fuhe5822720/-/购买元件和材料/购买元件和材料.docx

1. 外壳可以在建模sw中打开看，可以用3D打印
2. 电子元器件中的RGB灯可以用拼多多同款，便宜放心用
3. 电子元器件中的电容可以用淘宝同款，找靠谱店，便宜放心用
4. 嘉立创其他材料中的磁吸公母座可以用拼多多同款，大厂的便宜放心用
5. 嘉立创其他材料中USB磁吸充电电缆，改良了，这个太贵了，直接去掉
6. Esp8266min可以用淘宝up主同款，价格和拼多多差不多，但是拼多多人机客服，淘宝可以指点一下
7. 连接Esp8266min的线可以直接用杜邦线，便宜，目前用没问题
