fuhe5822720/-/购买元件和材料/电子元件清单-立创商城.xls

 |  | 立 创 商 城 订 单 详 情 WWW.SZLCSC.COM
商品明细列表
序号 | 商品编号 | 品牌 | 厂家型号 | 封装 | 商品名称 | 订购数量（修改后） | 是否不发此货 | 毛重（kg） | 商品单价 | 商品金额
1 | C722956 | BRIGHT(博瑞泰) | TSX103G901-250 | SMD | 10*10*9 弯型六脚 凹型柄 梅花H5.0 贴片 250gf | 5个 |  | 0.001430 | ￥3.220000/个 | ￥16.10
2 | C114586 | worldsemi | WS2812B-B | 5050(mm) | RGB三色 （注意防潮，请查阅规格书中对应具体内容） | 210个 |  | 0.000157 | ￥0.412595/个 | ￥86.64
3 | C136621 | SAMSUNG(三星) | CL21B104KBFNNNE | 0805 | 100nF ±10% 50V | 100个 |  | 0.000034 | ￥0.053756/个 | ￥5.38
