fuhe5822720/-/购买元件和材料/嘉立创外的其他材料.xlsx

材料 | 规格 | 数量 | 参考链接 | 备注
磁吸公母座 | 直针 | 10个 | https://item.taobao.com/item.htm?spm=a1z09.2.0.0.67002e8djU4Rxp&id=645077419824&_u=sd0tp5f8317 | 根据自己想做多少个模块觉得
USB磁吸充电电缆 | 白色直针 | 1 | https://item.taobao.com/item.htm?spm=a1z09.2.0.0.67002e8djU4Rxp&id=621136863981&_u=sd0tp5f55d2
螺丝 | M2*8【200颗】 | 1 | https://detail.tmall.com/item.htm?_u=sd0tp5f48bf&id=599899192777&spm=a1z09.2.0.0.67002e8djU4Rxp
亚克力 | 定制 | 看需求 | https://item.taobao.com/item.htm?spm=a1z09.2.0.0.67002e8djU4Rxp&id=40672059104&_u=sd0tp5f3cb8
防尘罩 | 根据模块数量决定 | 1 | https://item.taobao.com/item.htm?spm=a1z09.2.0.0.67002e8djU4Rxp&id=676704962844&_u=sd0tp5fbdb1
其他材料工具 | 热熔胶，电烙铁等常用电子制作工具
