fuhe5822720/-/模型文件/通用模块.SLDASM

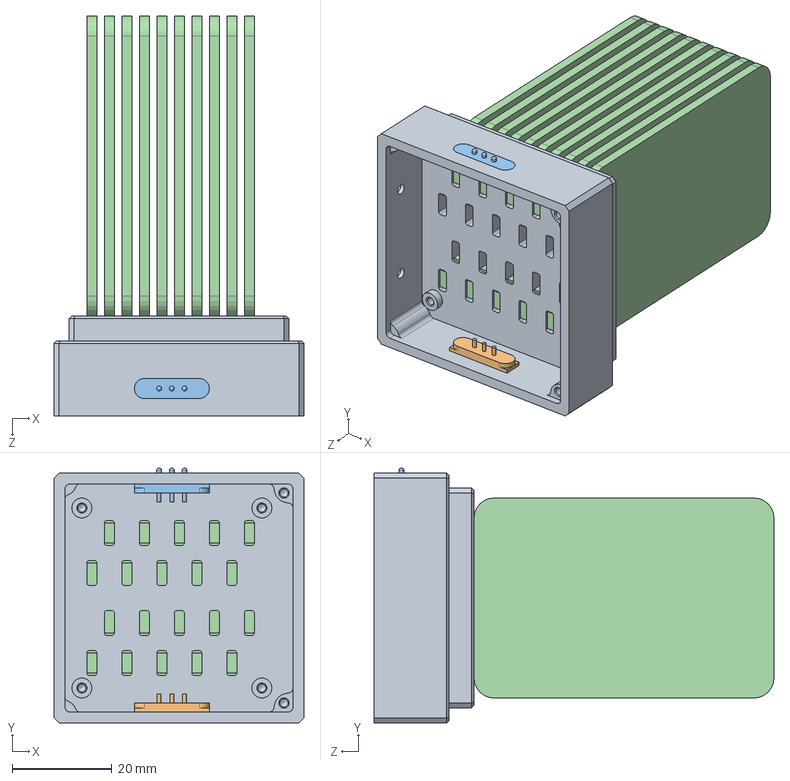
[picture p10: CAD file, 2026-10-09]
模型文件/通用模块.SLDASM
50.0 x 51.0 x 80.0 mm
底座_通用
3pin_母
3pin_公
亚克力显示片 x 10
