fuhe5822720/-/模型文件/总装配.SLDASM

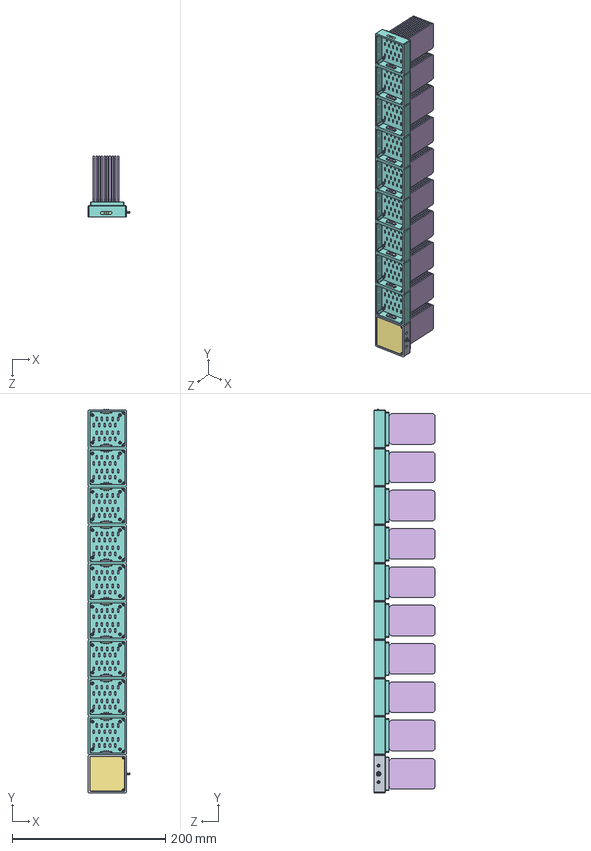
[picture p11: CAD file, 2026-10-09]
模型文件/总装配.SLDASM
54.5 x 501.0 x 80.0 mm
底座_信号0位
3D_led板_整体版
3D_5向开关_2022-10-30
3pin_公 x 10
电源2pin_母
亚克力显示片 x 100
底部盖子
底座_通用 x 9
3pin_母 x 9
