fuhe5822720/-/模型文件/信号模块_0位.SLDASM

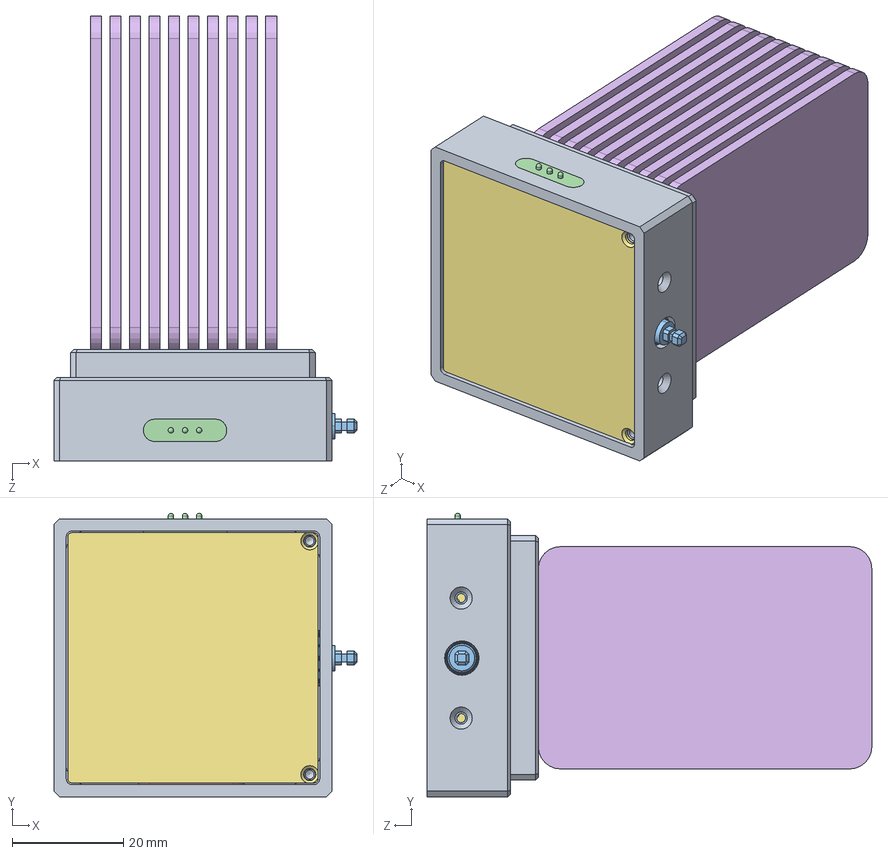
[picture p12: CAD file, 2026-10-09]
模型文件/信号模块_0位.SLDASM
54.5 x 51.0 x 80.0 mm
底座_信号0位
3D_led板_整体版
3D_5向开关_2022-10-30
3pin_公
电源2pin_母
亚克力显示片 x 10
底部盖子
