fuhe5822720/-/模型文件/亚克力显示片.SLDPRT

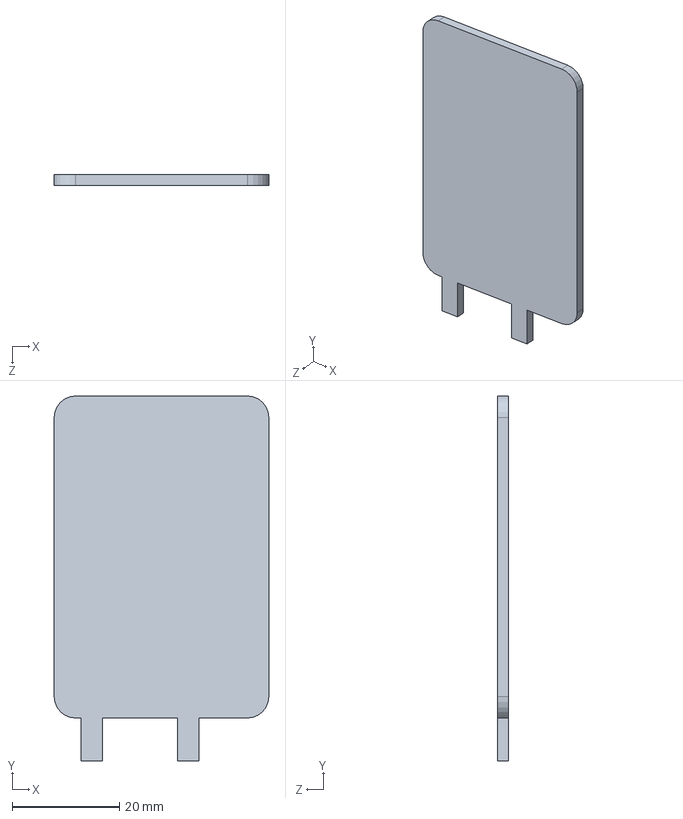
[picture p13: CAD file, 2026-10-09]
模型文件/亚克力显示片.SLDPRT
40.0 x 68.0 x 2.00 mm
