fuhe5822720/-/模型文件/led板_详细特征版.SLDPRT

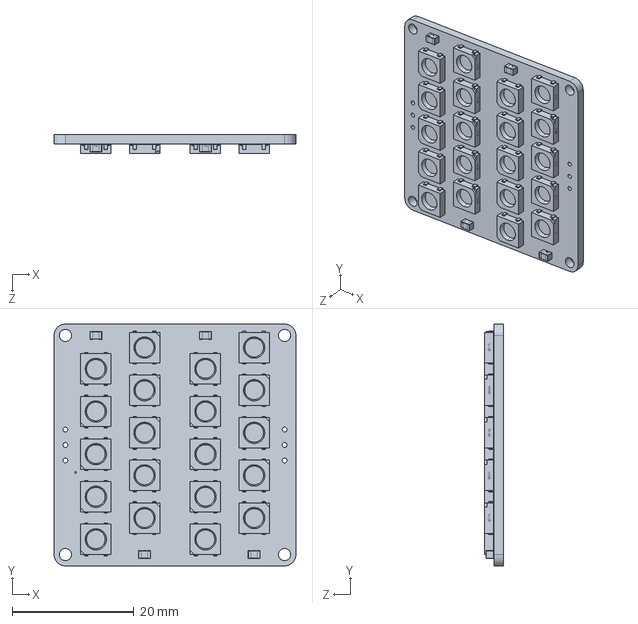
[picture p14: CAD file, 2026-10-09]
模型文件/led板_详细特征版.SLDPRT
39.7 x 39.7 x 3.17 mm
