fuhe5822720/-/模型文件/底部盖子.SLDPRT

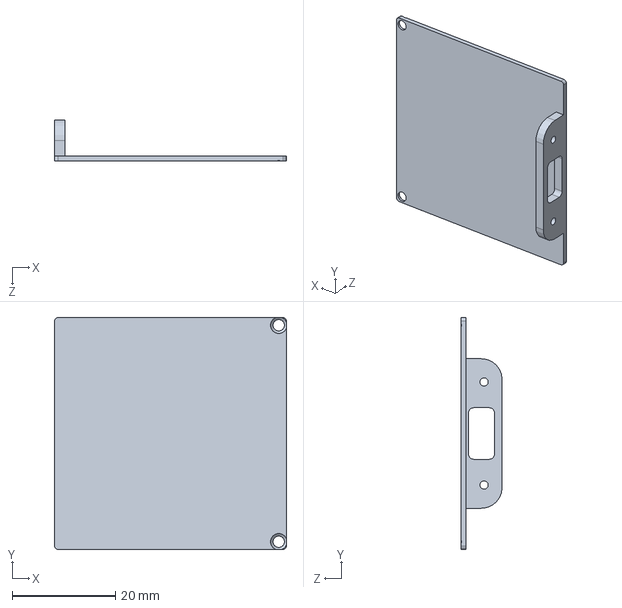
[picture p15: CAD file, 2026-10-09]
模型文件/底部盖子.SLDPRT
45.0 x 45.0 x 8.00 mm
