fuhe5822720/-/模型文件/雕刻固定框.SLDPRT

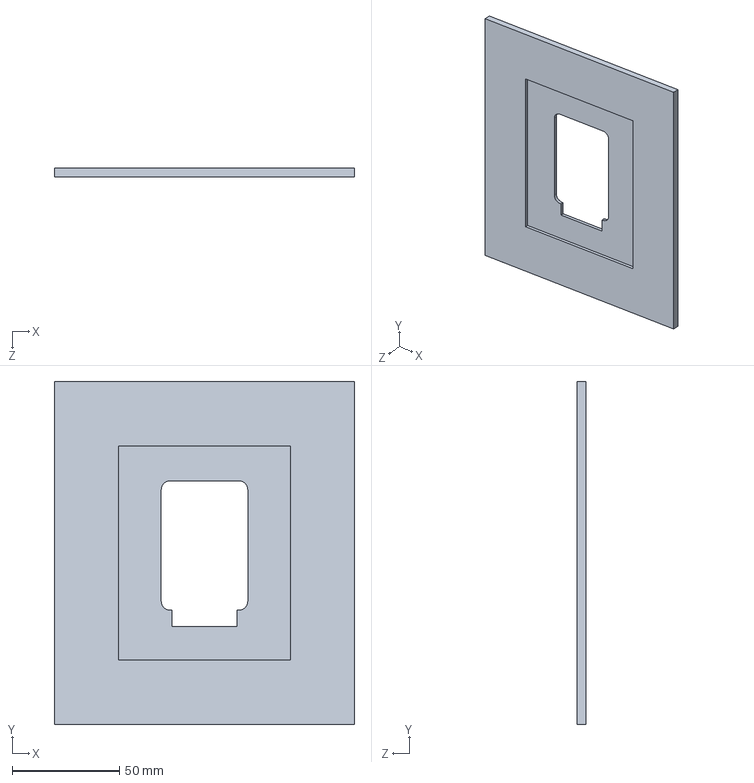
[picture p16: CAD file, 2026-10-09]
模型文件/雕刻固定框.SLDPRT
140.0 x 160.0 x 4.00 mm
