fuhe5822720/-/模型文件/3pin_公.SLDPRT

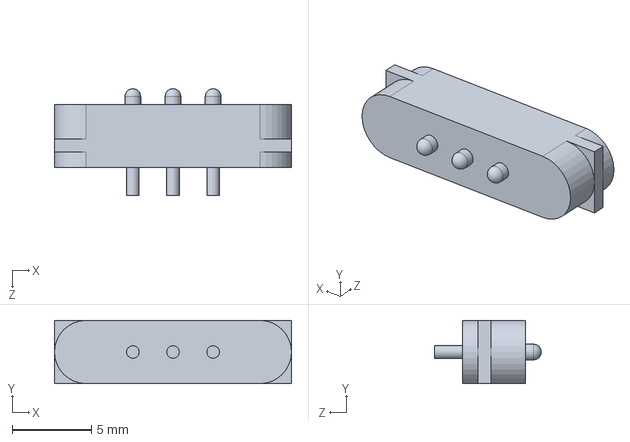
[picture p17: CAD file, 2026-10-09]
模型文件/3pin_公.SLDPRT
15.0 x 4.00 x 6.75 mm
