fuhe5822720/-/模型文件/电源2pin_母.SLDPRT

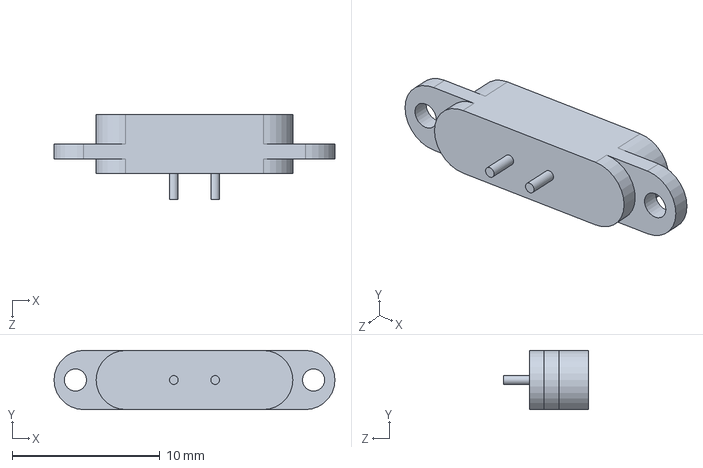
[picture p18: CAD file, 2026-10-09]
模型文件/电源2pin_母.SLDPRT
19.0 x 4.00 x 5.75 mm
