fuhe5822720/-/模型文件/3pin_母.SLDPRT

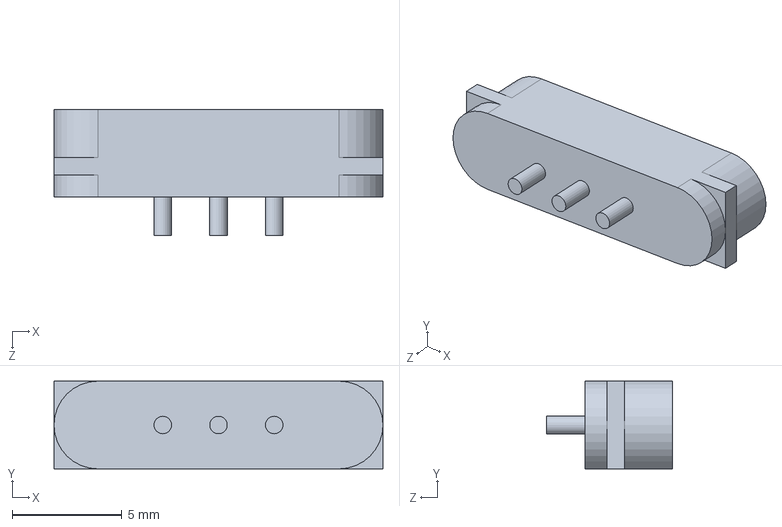
[picture p19: CAD file, 2026-10-09]
模型文件/3pin_母.SLDPRT
15.0 x 4.00 x 5.75 mm
