fuhe5822720/-/模型文件/底座_通用.STEP

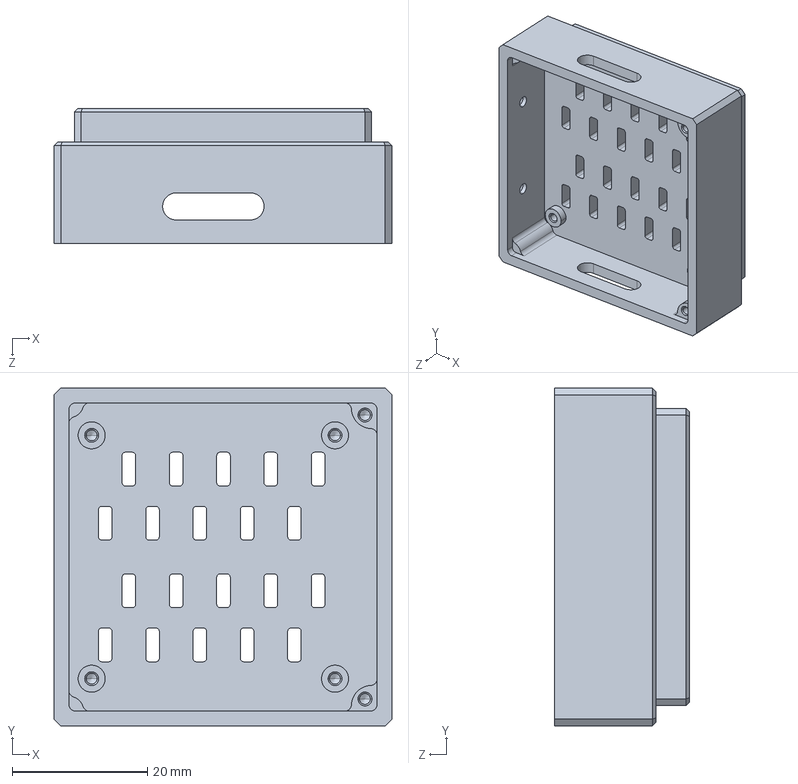
[picture p20: CAD file, 2026-10-09]
模型文件/底座_通用.STEP
50.0 x 50.0 x 20.0 mm
