fuhe5822720/-/模型文件/3D_5向开关_2022-10-30.step

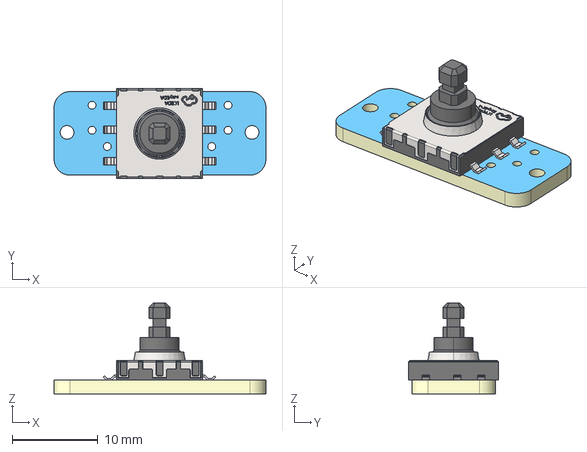
[picture p21: CAD file, 2026-10-09]
模型文件/3D_5向开关_2022-10-30.step
24.7 x 10.5 x 10.6 mm
