fuhe5822720/-/(list of files, cad)

Other CAD files:
亚克力图案.dwg
模型文件/生产文件/底座_通用.DWG
模型文件/生产文件/底座_信号0位.DWG
模型文件/小电视草图.SLDPRT
模型文件/动画收藏草图.DWG
模型文件/投币草图.SLDPRT
模型文件/3D_led板_整体版.SLDPRT
模型文件/3D_led板_装配版.step
模型文件/亚克力显示片新.DWG
模型文件/动画点赞草图.DWG
模型文件/点赞草图.SLDPRT
模型文件/收藏草图.SLDPRT
模型文件/小电视单线条草图.SLDPRT
模型文件/动画投币草图.DWG
模型文件/底座_信号0位.step.step
模型文件/零件1.SLDPRT
模型文件/数字0.SLDPRT
模型文件/防尘罩.SLDPRT
模型文件/底座_信号0位.STEP
模型文件/3D_5向开关_2022-10-30.SLDPRT
模型文件/亚克力显示片.DWG
模型文件/小电视单线条草图.DWG
模型文件/小电视草图.DWG
模型文件/底座_信号0位.SLDDRW
模型文件/底座_信号0位.SLDPRT
模型文件/底座_信号0位.STL
模型文件/底座_信号0位.step.SLDPRT
模型文件/底座_通用.SLDDRW
模型文件/底座_通用.SLDPRT
模型文件/底座_通用.STL
模型文件/底部盖子.STL
模型文件/投币草图.DWG
模型文件/收藏草图.DWG
模型文件/点赞草图.DWG
模型文件/雕刻固定框.STL
